bunker-stills/bunkerbox-docs/control-panel.md

# Control Panel

### Bill of Materials

| Name | Part No. | Qty | URL | Notes |
| --- | --- | ---: | --- | --- |
| TinkerForge RED Brick | | 1 | [Order Here](https://www.tinkerforge.com/en/shop/bricks/red-brick.html) | |
| TinkerForge Step Down Power Supply | | 1 | [Order Here](https://www.tinkerforge.com/en/shop/power-supplies/step-down-power-supply.html) | |
| TinkerForge Master Brick | | 2 | [Order Here](https://www.tinkerforge.com/en/shop/bricks/master-brick.html) | |
| TinkerForge Ethernet Master Extension | | 1 | [Order Here](https://www.tinkerforge.com/en/shop/master-extensions/ethernet-master-extension-without-poe.html) | (Optional) For wired connection |
| Wifi USB Adapter | | 1 | [Order Here](https://www.tinkerforge.com/en/shop/accessories/red-brick/wifi-usb-adapter.html) | (Optional) For wireless connection |
| TinkerForge Industrial Analog Out Bricklet | | 3 | [Order Here](https://www.tinkerforge.com/en/shop/bricklets/industrial/industrial-analog-out-bricklet.html) | |
| TinkerForge Industrial Quad Relay Bricklet| | 1 | [Order Here](https://www.tinkerforge.com/en/shop/bricklets/industrial/industrial-quad-relay-bricklet.html) | |
| TinkerForge Barometer Bricklet| | 1 | [Order Here](https://www.tinkerforge.com/en/shop/bricklets/sensors/barometer-bricklet.html) | |
| TinkerForge 12mm Mounting Kit| | 10 | [Order Here](https://www.tinkerforge.com/en/shop/accessories/mounting/mounting-kit-12mm.html) | |
| TinkerForge Rail Mounting Kit| | 2 | [Order Here](https://www.tinkerforge.com/en/shop/accessories/mounting/rail-mounting-kit.html) | (Optional) For DIN rail mounting |
| TinkerForge 15cm Bricklet Cable| | 6 | [Order Here](https://www.tinkerforge.com/en/shop/accessories/cable/bricklet-cable-black-15cm.html) | |
| Power Distribution Block | EPDB104 | 3 | [Order Here](https://www.automationdirect.com/adc/Shopping/Catalog/Power_Products_(Electrical)/Power_Distribution_Blocks/Finger_Safe,_UL_Listed,_175A-760A_(EPDB_Series)/EPDB104) | |
| 40A Contactor | SC-E2-220VAC | 1 | [Order Here](https://www.automationdirect.com/adc/Shopping/Catalog/Motor_Controls/IEC_Contactors_-z-_Starters_-z-_Overloads/Fuji_Contactors_-z-_Overloads/32_to_50_Amp/SC-E2-220VA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) | |
| 240W 24V DC Power Supply | NDR-240-24 | 1 | [Order Here](https://www.mouser.com/ProductDetail/MEAN-WELL/NDR-240-24?qs=RIWDSyqdxDaIKDkc7DPtWw%3D%3D) | |
| SSR Control Module | SSRMAN-1P-HR | 2 | [Order Here](https://nuwaveautomation.com/product/solid-state-relay-phase-angle-control-module-ssrman-1p/) | |
| SSR 24V Control Transformer | 90-T40F3 | 1 | [Order Here](https://nuwaveautomation.com/product/control-transformer-24v-secondary-120208240-primary-60hz/) | |
| SSR | D2425-10 | 2 | [Order Here](https://nuwaveautomation.com/product/solid-state-relay-random-firinginstant-on/) | D2450-10 or greater may be used for higher power scenarios |
| 10AMP Breaker | FAZ-B10-2 | 2 | [Order Here](https://www.automationdirect.com/adc/Shopping/Catalog/Circuit_Protection_-z-_Fuses_-z-_Disconnects/UL_1077_Rated_Supplementary_Protectors/Double_Pole_Supplementary_P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) | Amp rating may vary depending on power requirements |
| 40AMP Breaker | FAZ-B40-2 | 1 | [Order Here](https://www.automationdirect.com/adc/Shopping/Catalog/Circuit_Protection_-z-_Fuses_-z-_Disconnects/UL_1077_Rated_Supplementary_Protectors/Double_Pole_Supplementary_P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) | Amp rating may vary depending on power requirements |
| 240VAC LED Power Indicator Lamp | ELDE.NRT230 | 1 | [Order Here](https://www.automationdirect.com/adc/Shopping/Catalog/Pushbuttons_-z-_Switches_-z-_Indicators/Schmersal_22mm_(IP69K,_N_Series)/22mm_Pushbutton_Accessories/Lamps_-a-_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) | |
| LED Power Indicator Housing | NMLRT | 1 | [Order Here](https://www.automationdirect.com/adc/Shopping/Catalog/Pushbuttons_-z-_Switches_-z-_Indicators/Schmersal_22mm_(IP69K,_N_Series)/Indicator_Lights/NMLRT) | |
| ESTOP Contact Block | EF220.2 | 1 | [Order Here](https://www.automationdirect.com/adc/Shopping/Catalog/Pushbuttons_-z-_Switches_-z-_Indicators/Schmersal_22mm_(IP69K,_N_Series)/22mm_Pushbutton_Accessories/Contact_Bl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) | |
| ESTOP Button | NDRZ50RT | 1 | [Order Here](https://www.automationdirect.com/adc/Shopping/Catalog/Pushbuttons_-z-_Switches_-z-_Indicators/Schmersal_22mm_(IP69K,_N_Series)/Emergency_Stop_-a-_Mushroom_Pushbutton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) | |

### Additional Wiring Aides

| Name | Part No. | Qty | URL | Notes |
| --- | --- | ---: | --- | --- |
| 3 Level DIN Terminal Blocks | DN-TL14-A | 1 | [Order Here](https://www.automationdirect.com/adc/Shopping/Catalog/Terminal_Blocks/DINnector_DIN-Rail_Terminal_Blocks/Triple-level_Feed-Through_Terminal_Blocks/DN-TL14-A) | Pkg of 25 |
| Terminal Block Jumpers  | DN-12JL14B-A | 1 | [Order Here](https://www.automationdirect.com/adc/Shopping/Catalog/Terminal_Blocks/DINnector_DIN-Rail_Terminal_Blocks/Jumpers_-a-_Tools/DN-12JL14B-A) | Pkg of 10 |
| Terminal Block End Cap  | DN-EC14 | 1 | [Order Here](https://www.automationdirect.com/adc/Shopping/Catalog/Terminal_Blocks/DINnector_DIN-Rail_Terminal_Blocks/End_Covers/DN-EC14) | Pkg of 25 |
| M12 Female Bulkhead Connector  | 7231-13501-9710050 | X | [Order Here](https://www.automationdirect.com/adc/Shopping/Catalog/Cables/Sensors_-z-_Switches/Micro_(M12)_Receptacles/7231-13501-9710050) | Depends on number of external connections. Works well for temp probes, pump, and solenoid connections. |
