bunker-stills/bunkerbox-docs/schematics/bunkerbox-v3.pdf

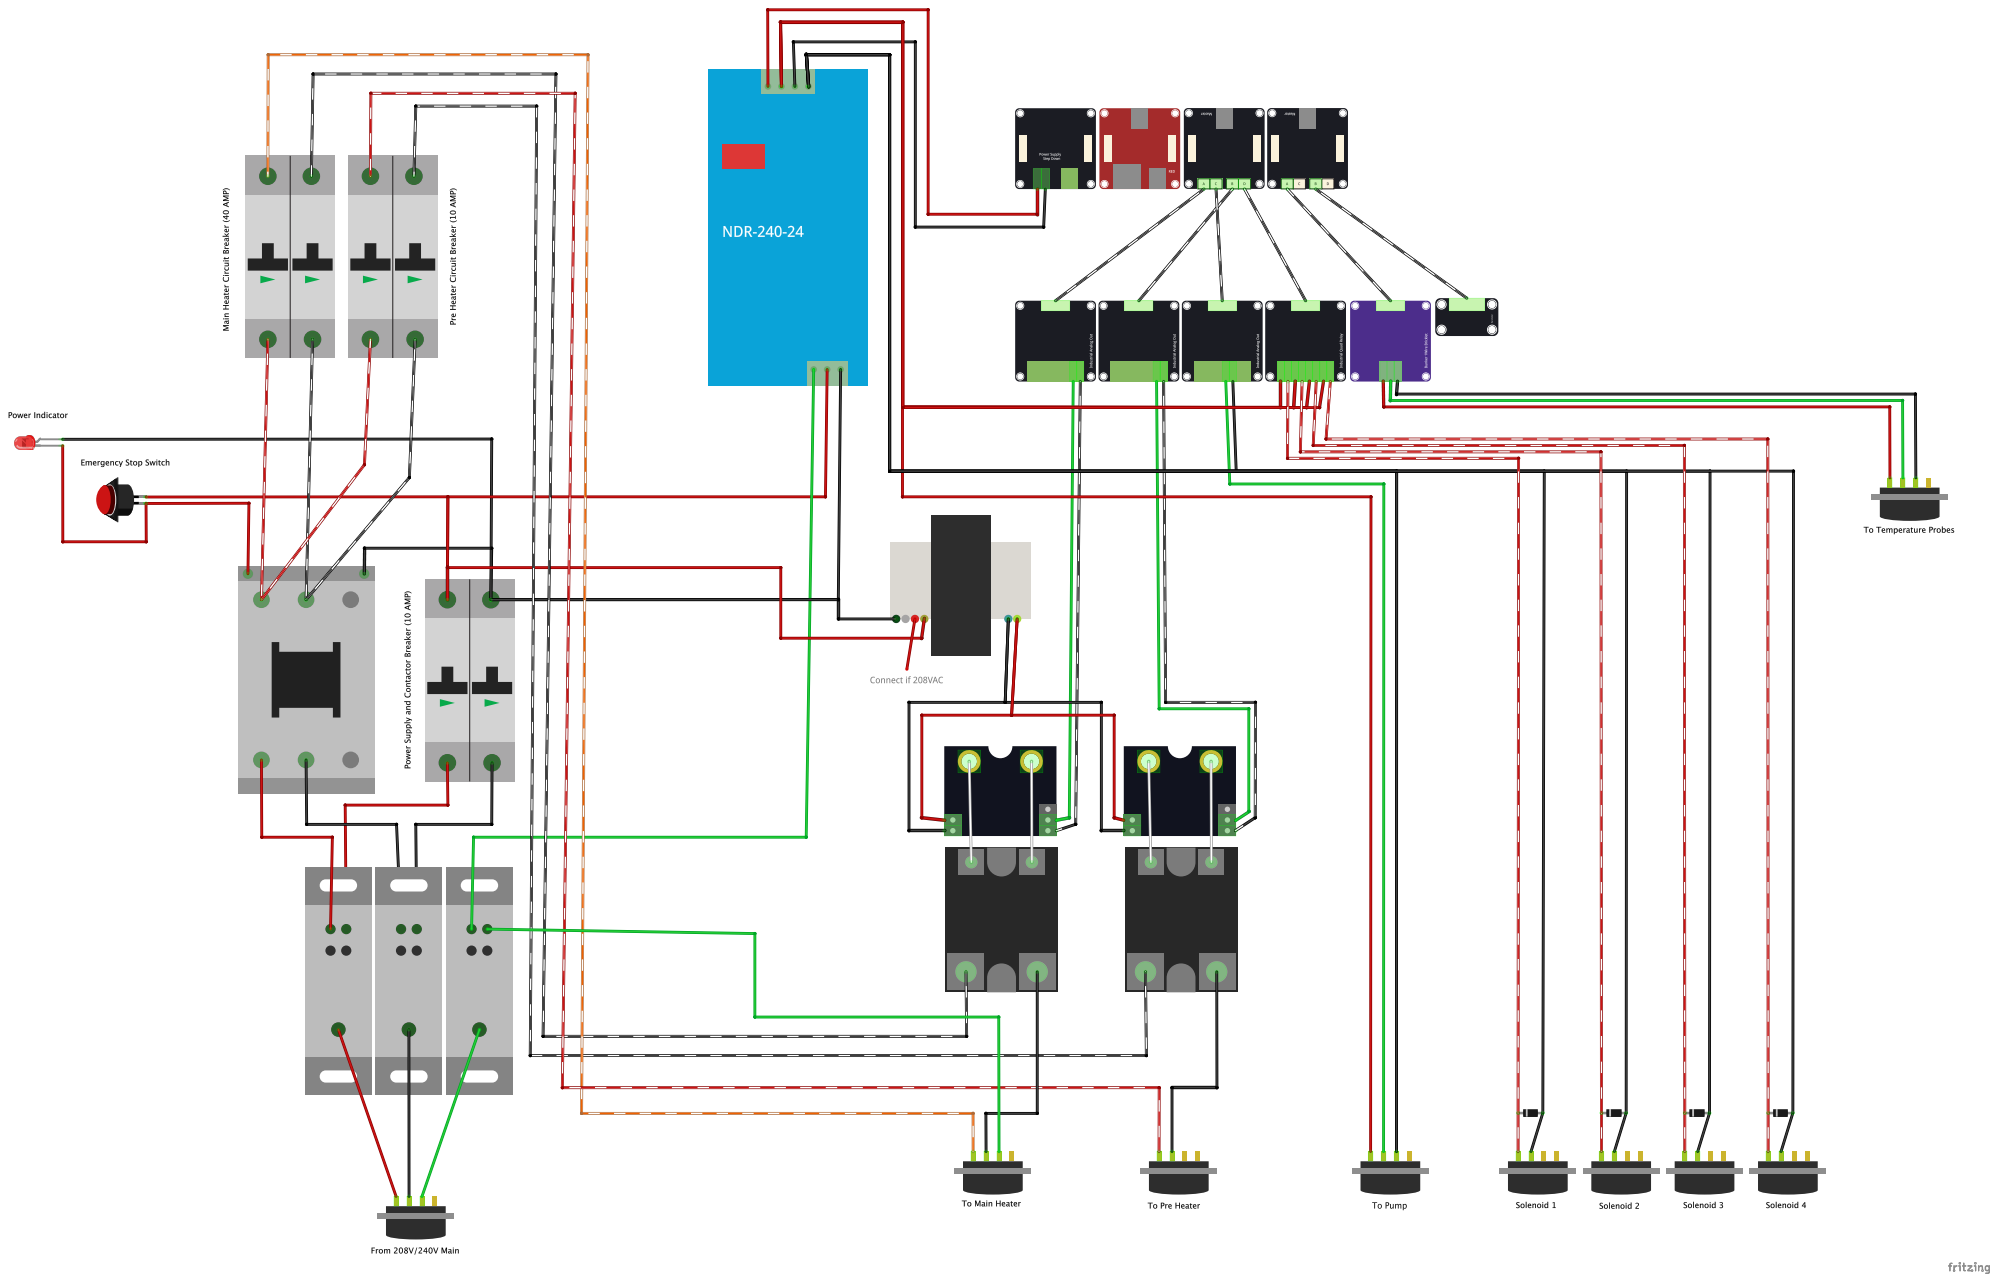
[picture p1: page 1]
