bunker-stills/bunkerbox-docs/(list of files, drawings)

Other design files:
schematics/bunkerbox-v3.fzz
