bunker-stills/bunkerbox-docs/(commit log)

2018-05-23 more docs
    [bunkerbox-v3.fzz]
2018-05-24 More updates
    [bunkerbox-v3.fzz]
